motine/tomato/final.jpg

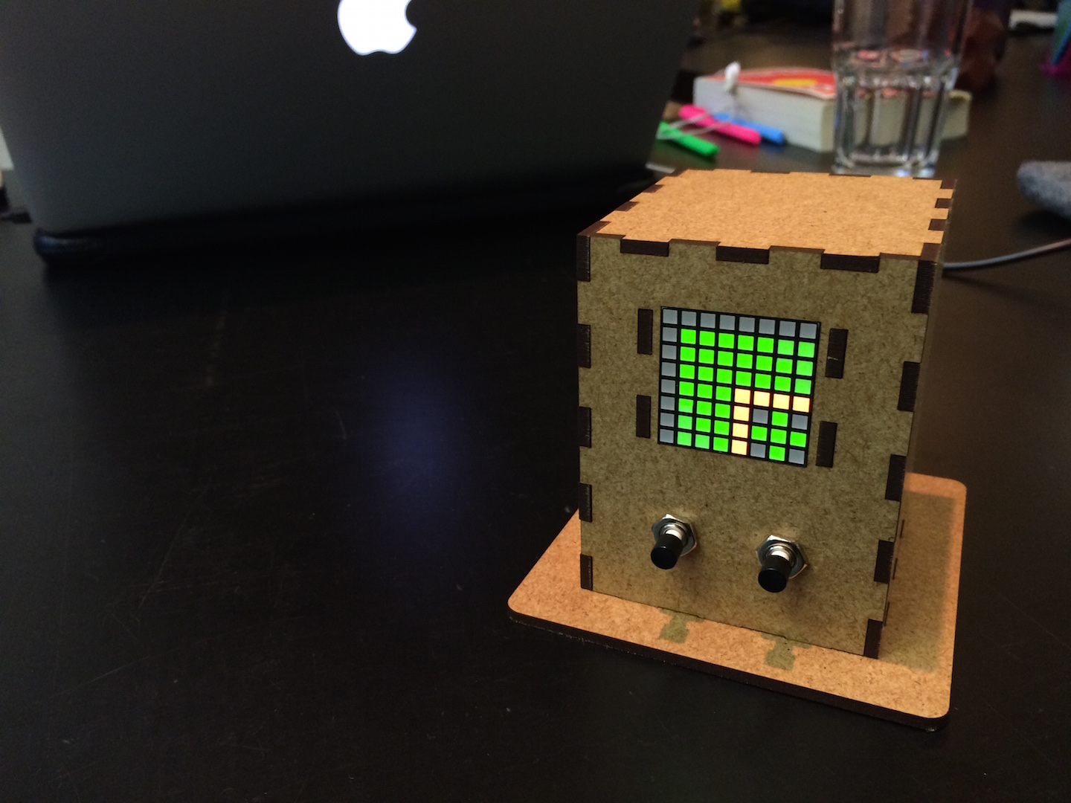
final.jpg
