motine/tomato/circuit.pdf

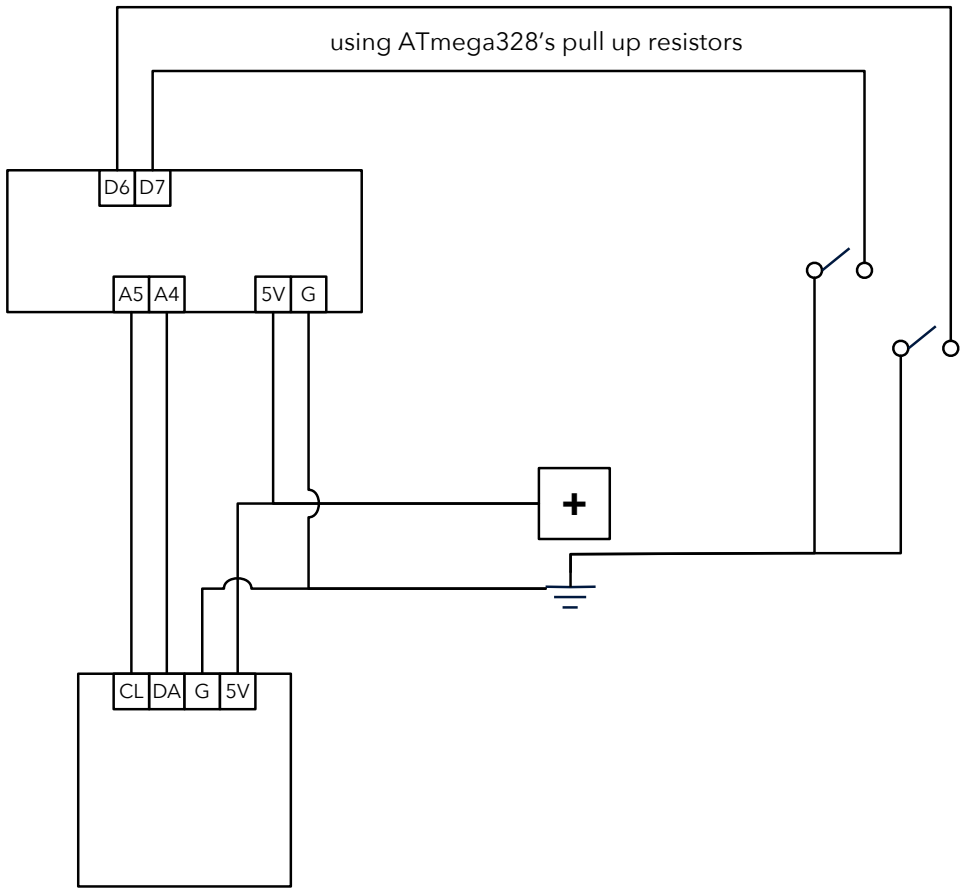
[picture p2: figure]
using ATmega328’s pull up resistors
