motine/tomato/box.pdf

## united

## copied from opposite side

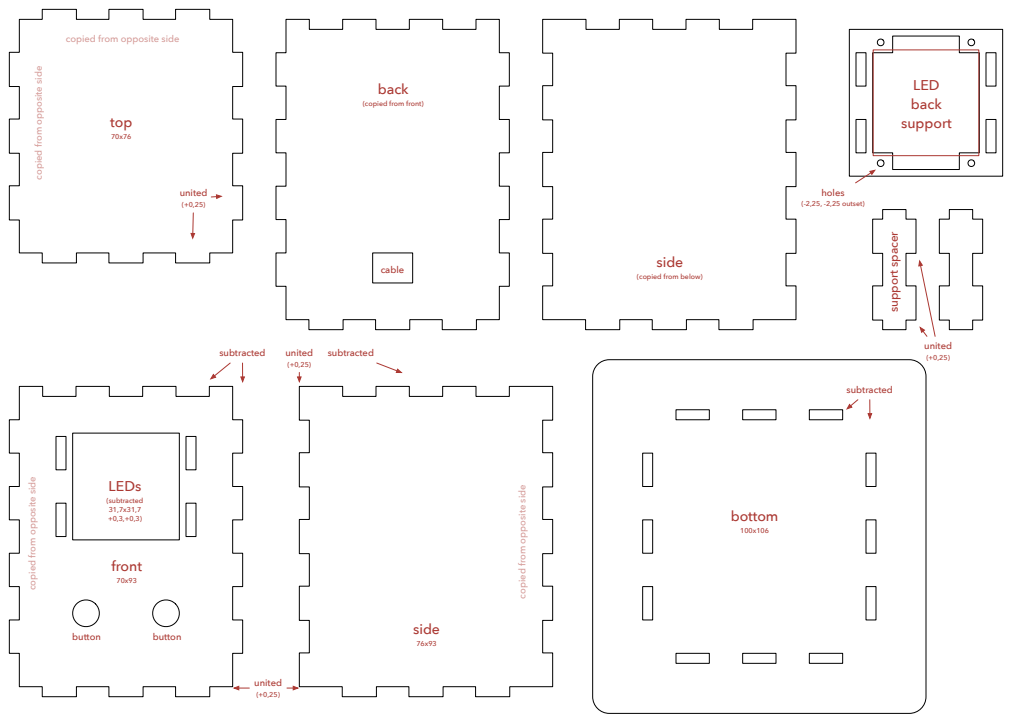
[picture p3: page 1]
subtracted; LEDs; (subtracted 31,7x31,7 +0,3,+0,3); united; front; side; bottom; top; united (+0,25); button; cable; back; holes (-2,25, -2,25 outset); LED back support; support spacer

copied from opposite side

(copied from front)

(copied from below)
